ys0o8qy/esp32_c3_0.42oled/BuildDefaults.h

#pragma once
// The build script replaces this file ONLY in its temporary sketch directory.
// Direct Arduino IDE/CLI builds use empty defaults and phone setup.
#define C3_WIFI_SSID ""
#define C3_WIFI_PASSWORD ""
#define C3_ROOM_NAME ""
#define C3_REPORT_URL ""
#define C3_REPORT_TOKEN ""
#define C3_REPORT_SECONDS 60
#define C3_THINGSBOARD 0
