ys0o8qy/esp32_c3_0.42oled/(commit log)

2026-10-09 fix: show live sample count on small OLED
    [c3_temperature.ino]
2026-10-11 feat: add env build defaults and ThingsBoard telemetry
    [Configuration.h]
2026-10-11 docs: record successful ThingsBoard device reporting
2026-10-11 feat: show current IP address on OLED status rotation
